SkyentificGit/SmallRobotArm/README.md

# SmallRobotArm
This is the open source project of the 6DoF robot arm based on stepper motors

All CAD and code is licensed under GPL3: https://www.gnu.org/licenses/gpl-3.0.en.html
