SkyentificGit/SmallRobotArm/Axis/Readme

The drawing of the metal axis for joint 3, 2 and 1.
