SkyentificGit/SmallRobotArm/Axis/Axis2tube.step

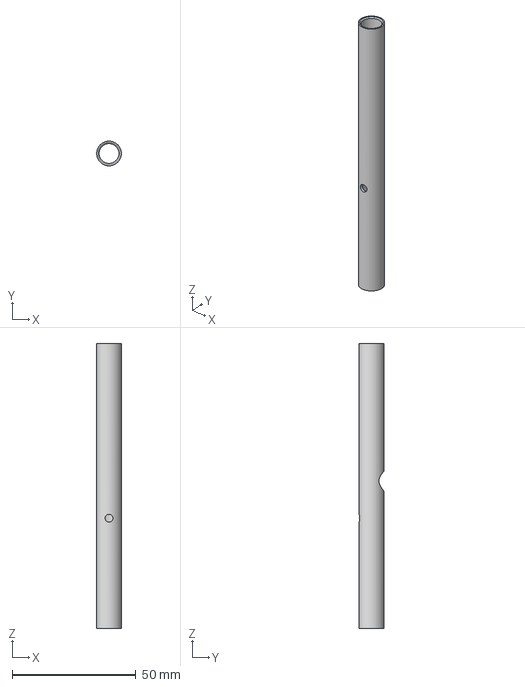
[picture p1: CAD file, 2019-01-30]
Axis/Axis2tube.step
9.99 x 10.00 x 115.0 mm
