SkyentificGit/SmallRobotArm/CarbonFibre/Axis2part1.stl

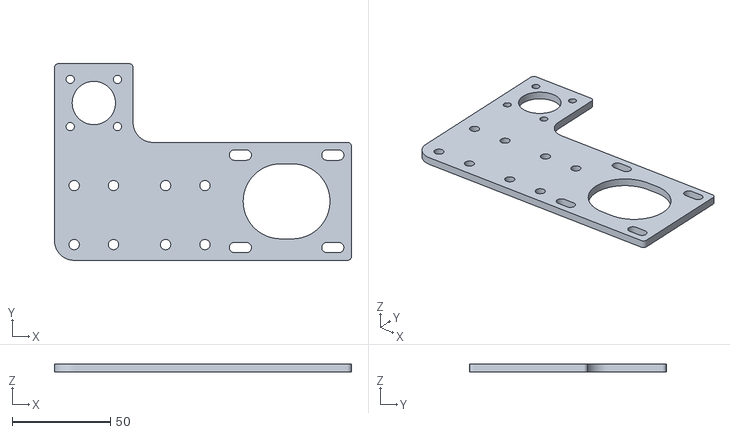
[picture p2: CAD file, 2019-01-02]
CarbonFibre/Axis2part1.stl
151.0 x 100.0 x 4.00
