SkyentificGit/SmallRobotArm/Fusion360/AxisTot1 v14.step

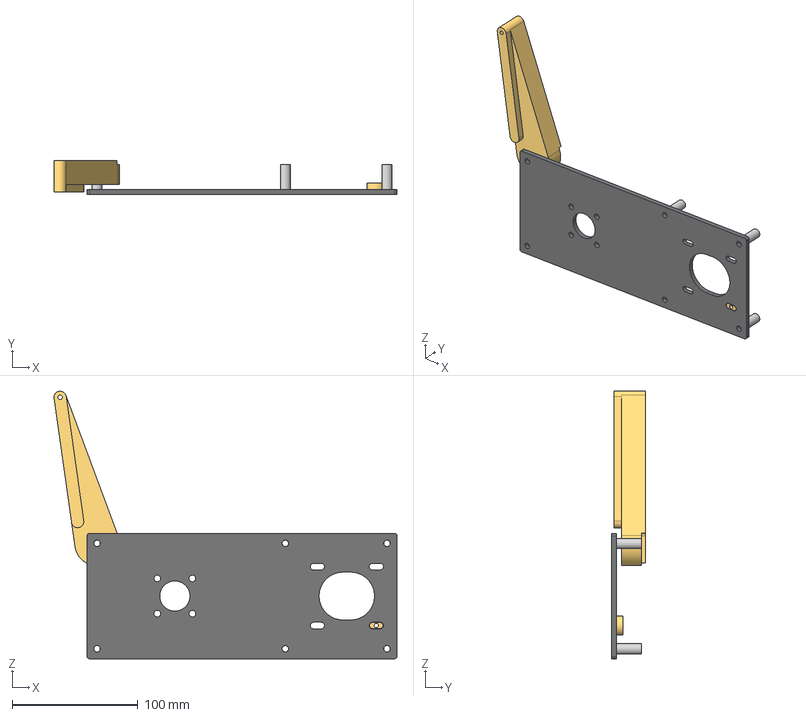
[picture p3: CAD file, 2019-09-09]
Fusion360/AxisTot1 v14.step
273.3 x 27.0 x 213.2 mm
Axis1part2_1
M5standoff_6 x 6
LegLeft
FootHolder
