SkyentificGit/SmallRobotArm/STL/Cover.stl

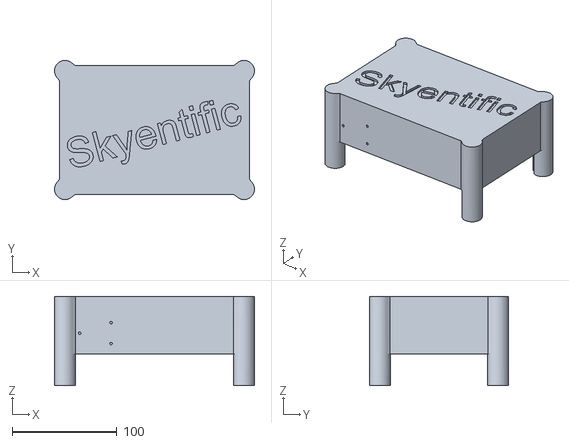
[picture p4: CAD file, 2019-02-20]
STL/Cover.stl
191.0 x 133.0 x 85.0
