SkyentificGit/SmallRobotArm/Axis/Axis3tube.step

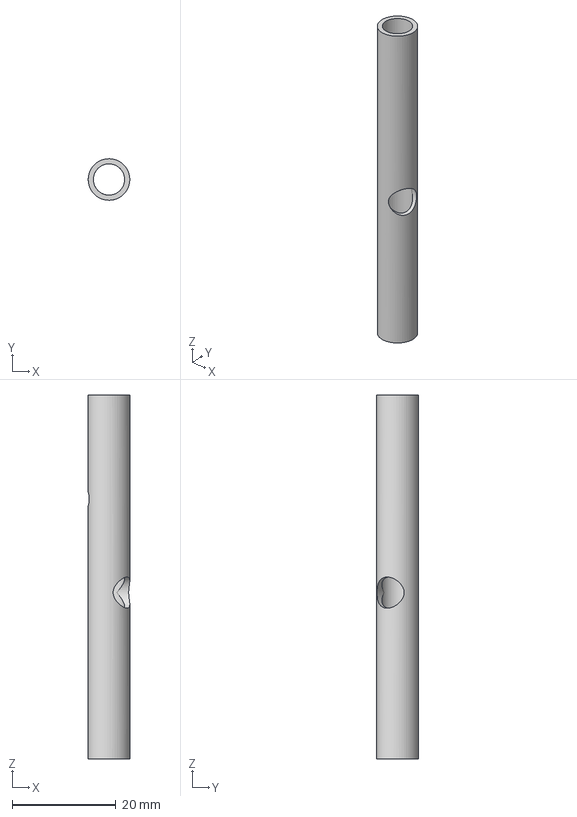
[picture p5: CAD file, 2019-01-30]
Axis/Axis3tube.step
8.00 x 8.00 x 70.0 mm
