SkyentificGit/SmallRobotArm/CarbonFibre/Axis1part2.stl

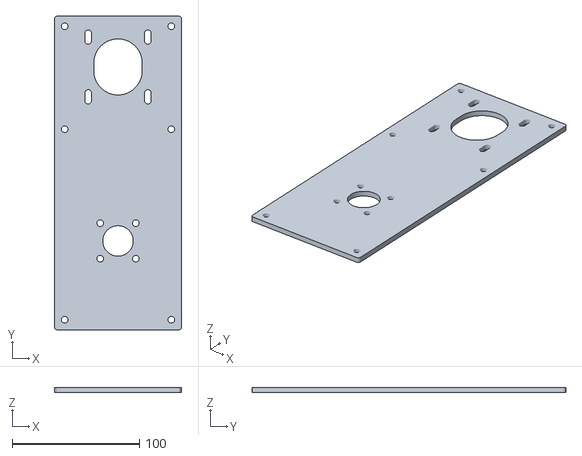
[picture p6: CAD file, 2019-01-02]
CarbonFibre/Axis1part2.stl
100.0 x 247.0 x 4.00
