SkyentificGit/SmallRobotArm/Fusion360/axis6motorHolder v47.step

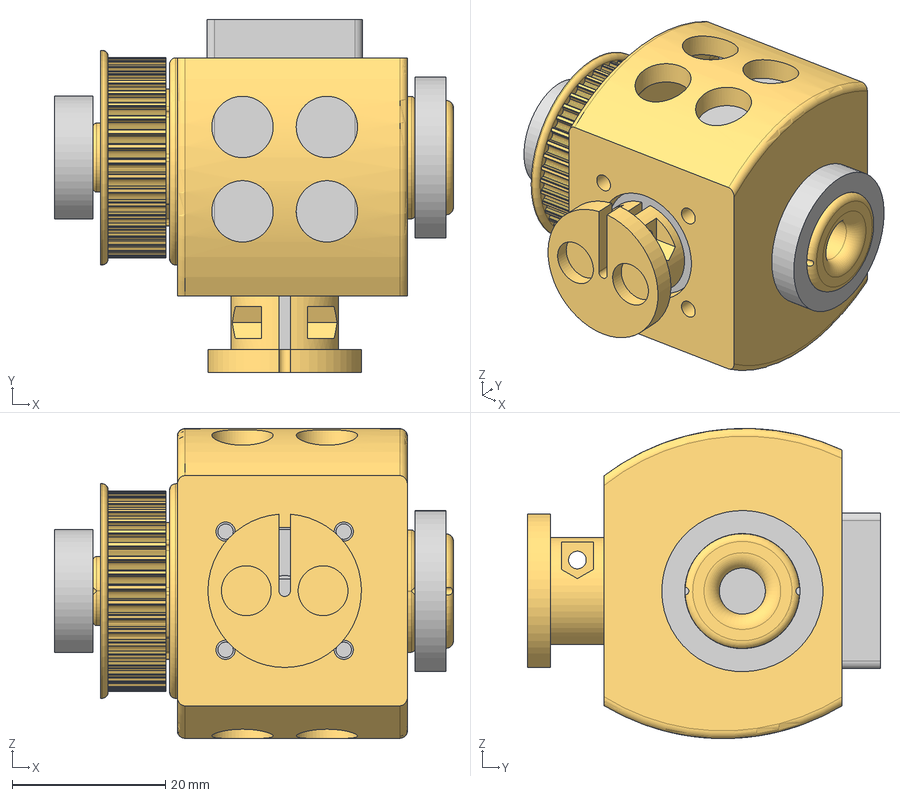
[picture p7: CAD file, 2019-09-09]
Fusion360/axis6motorHolder v47.step
52.0 x 46.0 x 40.4 mm
axis6motorHolder_1
Pulley42
Bearing16_8_5_1
Bearing21_15_4_1
Nema8_1
Axis6_1
