SkyentificGit/SmallRobotArm/STL/Electronics.stl

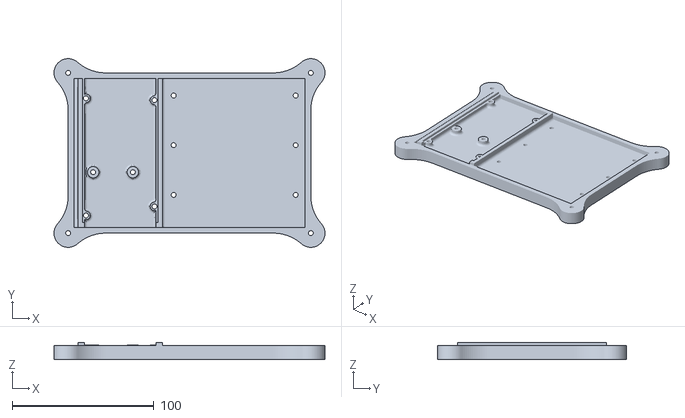
[picture p8: CAD file, 2019-01-26]
STL/Electronics.stl
191.0 x 133.0 x 12.2
