SkyentificGit/SmallRobotArm/Axis/Axis1tube.step

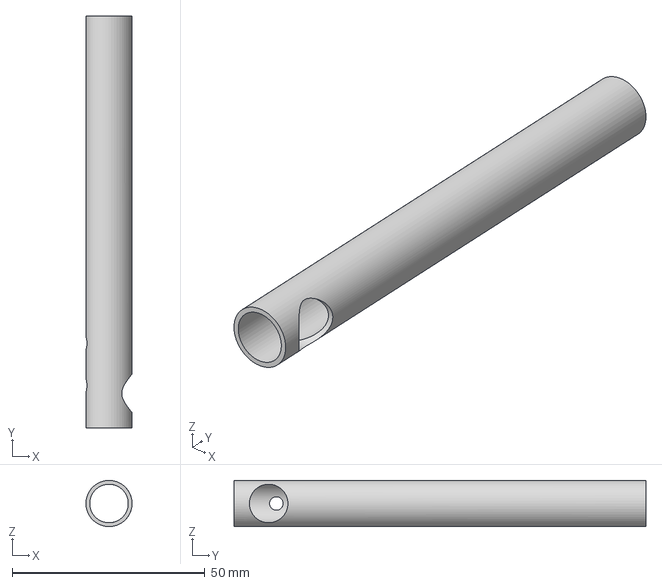
[picture p9: CAD file, 2019-01-30]
Axis/Axis1tube.step
12.0 x 107.0 x 12.0 mm
