SkyentificGit/SmallRobotArm/CarbonFibre/Axis3part1.stl

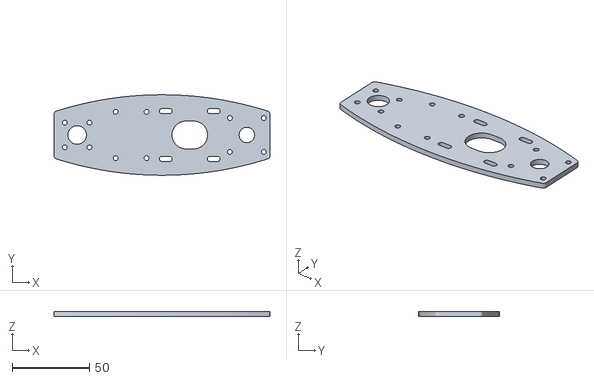
[picture p10: CAD file, 2019-01-02]
CarbonFibre/Axis3part1.stl
140.0 x 52.2 x 3.00
