SkyentificGit/SmallRobotArm/Fusion360/Axis6 v13.step

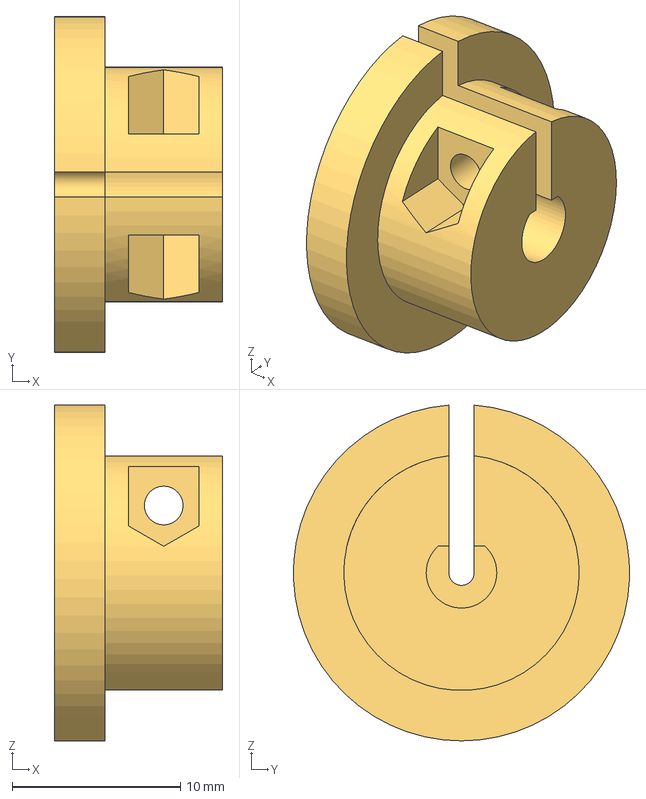
[picture p11: CAD file, 2019-09-09]
Fusion360/Axis6 v13.step
10.0 x 20.0 x 20.0 mm
