SkyentificGit/SmallRobotArm/STL/LegLeft.stl

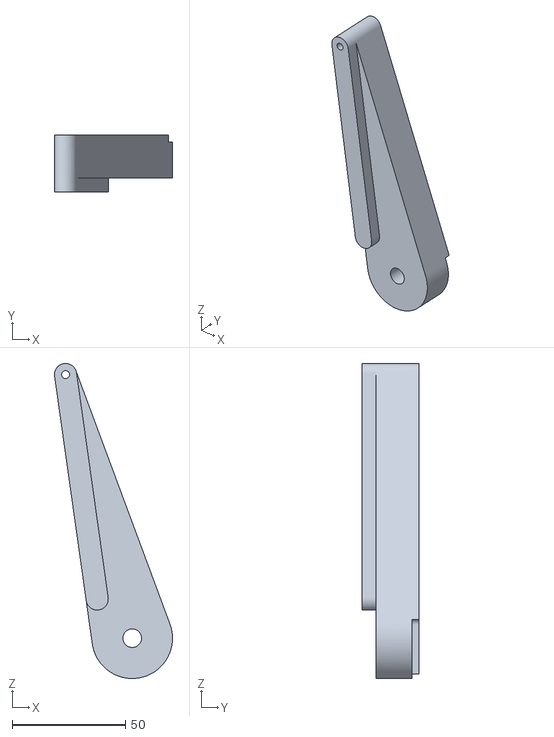
[picture p12: CAD file, 2019-01-14]
STL/LegLeft.stl
52.1 x 25.0 x 139.0
