SkyentificGit/SmallRobotArm/STL/Axis2bearingHC.stl

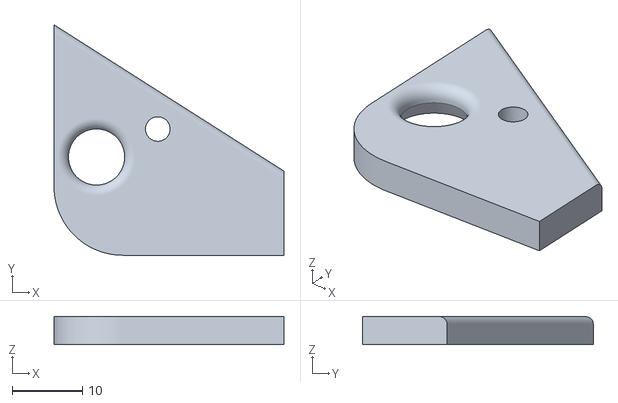
[picture p13: CAD file, 2019-01-02]
STL/Axis2bearingHC.stl
32.8 x 32.9 x 4.00
