SkyentificGit/SmallRobotArm/STL/Axis2part2.stl

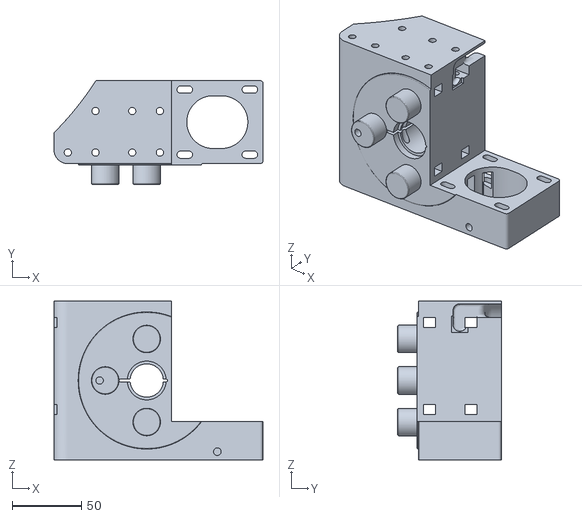
[picture p14: CAD file, 2019-01-02]
STL/Axis2part2.stl
151.0 x 75.0 x 114.8
