SkyentificGit/SmallRobotArm/STL/FootHolder.stl

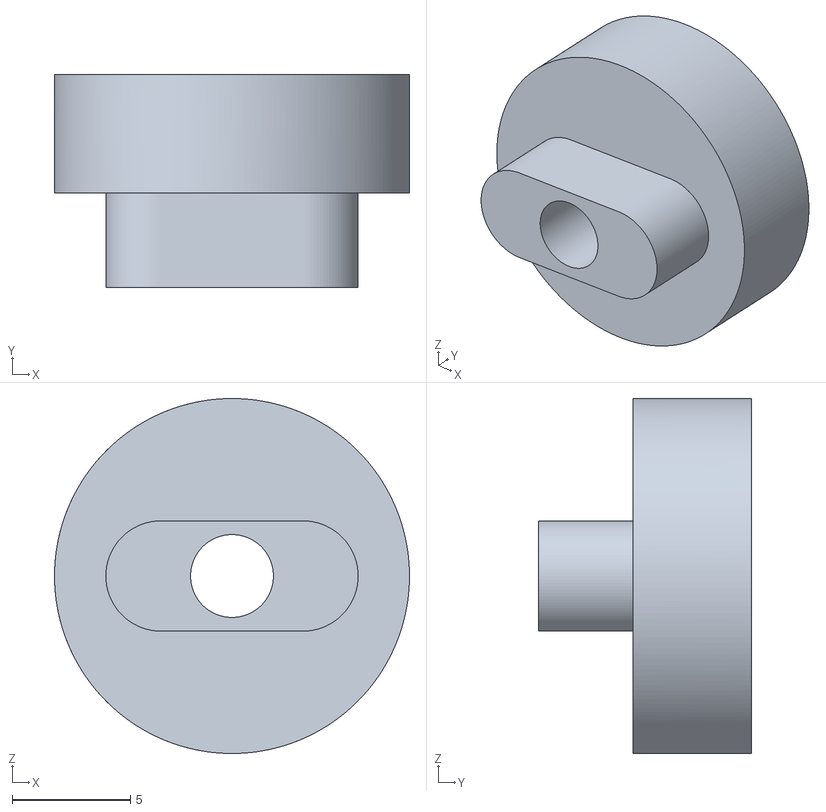
[picture p15: CAD file, 2019-01-02]
STL/FootHolder.stl
15.0 x 9.00 x 15.0
