SkyentificGit/SmallRobotArm/STL/Axis2MotorOpC.stl

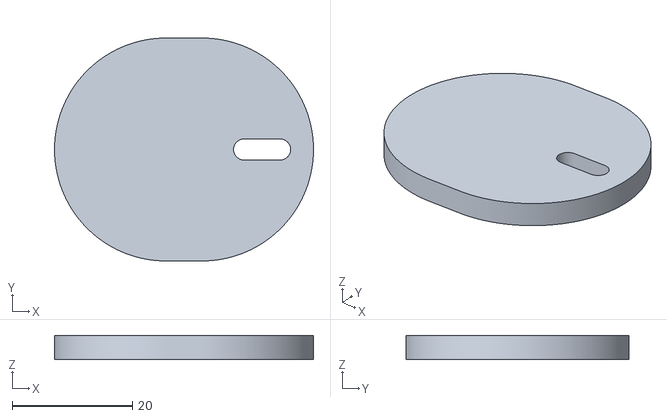
[picture p16: CAD file, 2019-01-02]
STL/Axis2MotorOpC.stl
43.1 x 37.1 x 4.00
