SkyentificGit/SmallRobotArm/STL/Axis2MotorOp.stl

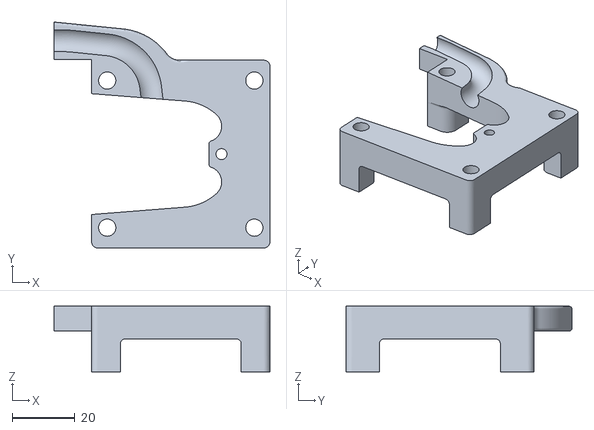
[picture p17: CAD file, 2019-01-02]
STL/Axis2MotorOp.stl
69.0 x 72.2 x 21.0
