SkyentificGit/SmallRobotArm/STL/Axis1MotorHolderOp.stl

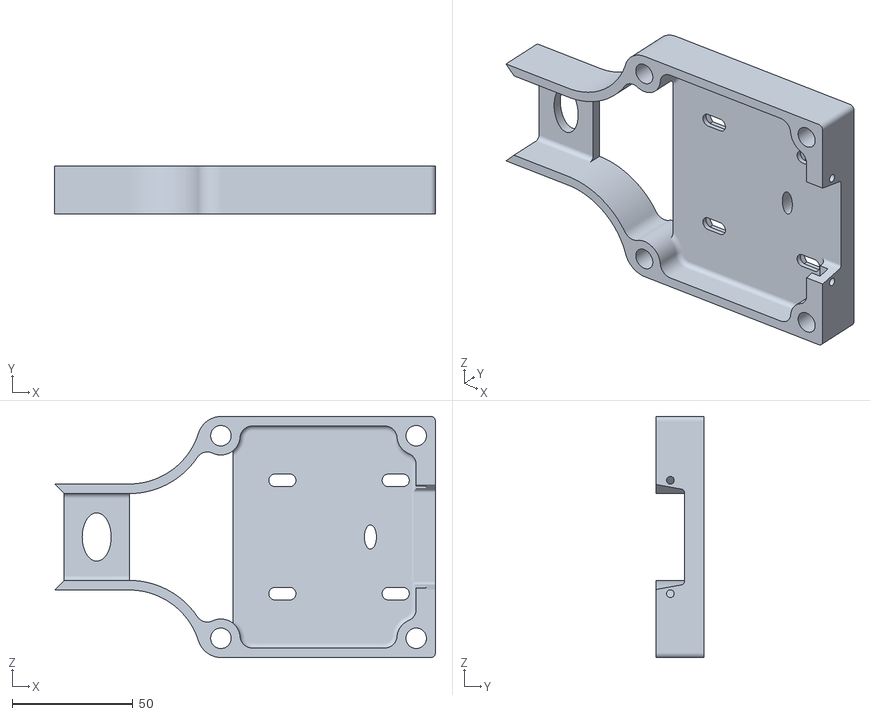
[picture p18: CAD file, 2019-01-02]
STL/Axis1MotorHolderOp.stl
158.0 x 20.0 x 100.0
