SkyentificGit/SmallRobotArm/STL/Axis1Pulley.stl

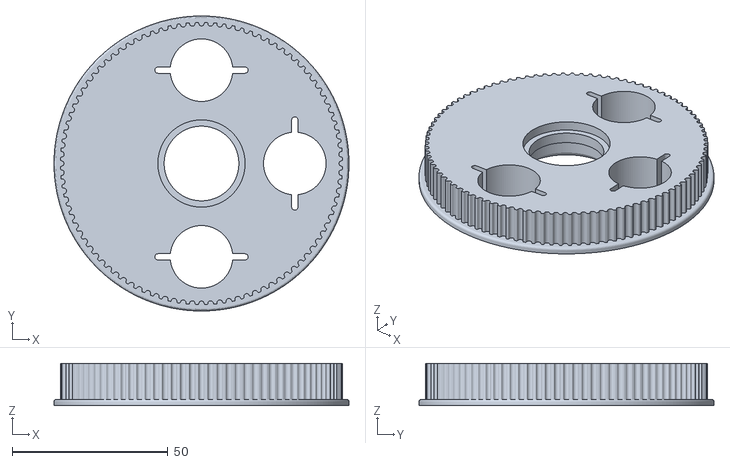
[picture p19: CAD file, 2019-01-02]
STL/Axis1Pulley.stl
94.8 x 94.8 x 13.5
