SkyentificGit/SmallRobotArm/STL/Axis2bearingHolder.stl

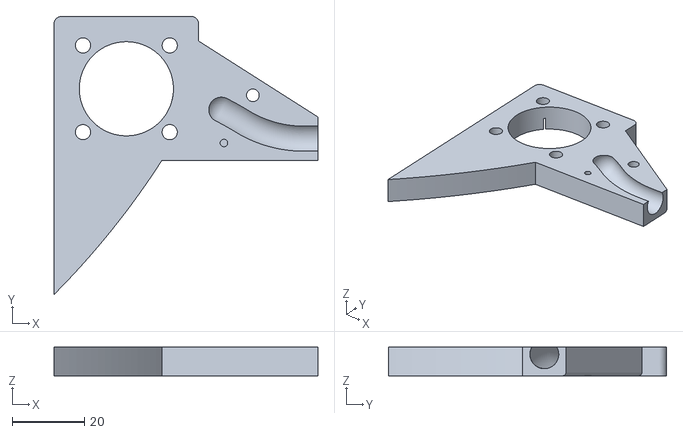
[picture p20: CAD file, 2019-01-02]
STL/Axis2bearingHolder.stl
73.0 x 76.9 x 8.00
