SkyentificGit/SmallRobotArm/STL/Axis1MotorHolder.stl

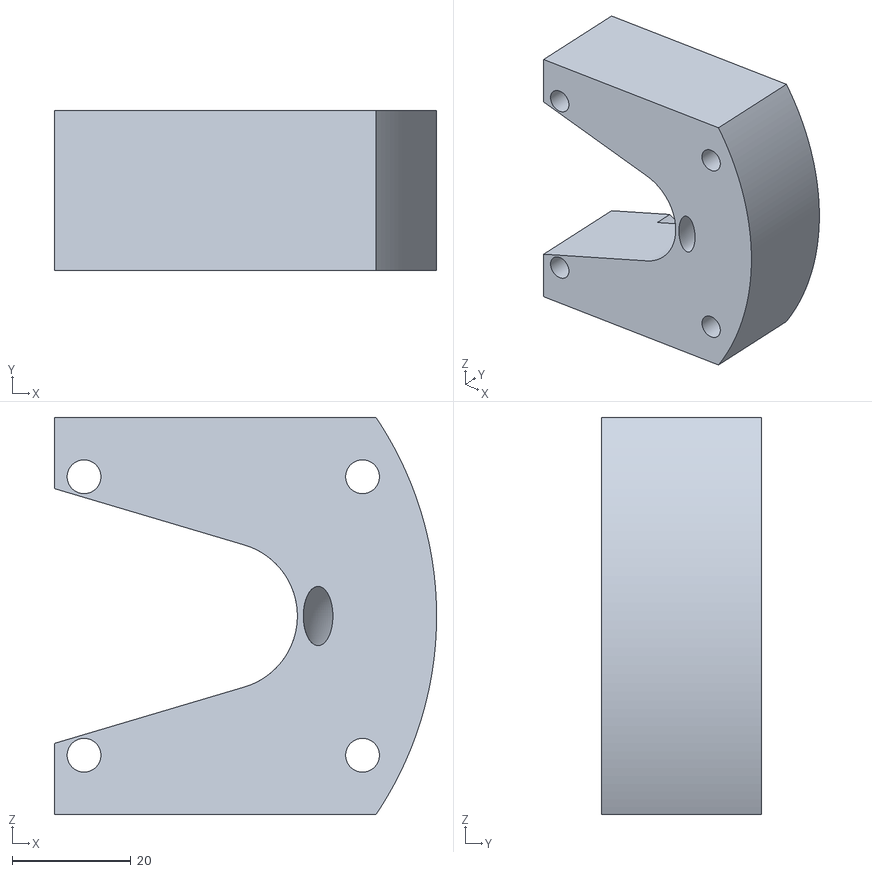
[picture p21: CAD file, 2019-01-02]
STL/Axis1MotorHolder.stl
64.5 x 27.0 x 67.0
