SkyentificGit/SmallRobotArm/STL/Axis1Holder.stl

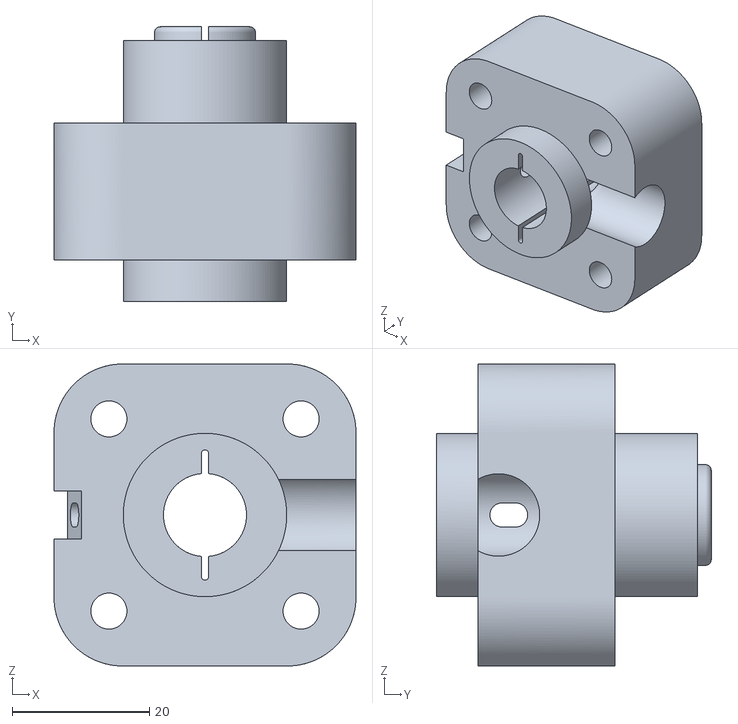
[picture p22: CAD file, 2019-01-02]
STL/Axis1Holder.stl
44.0 x 40.0 x 44.0
