SkyentificGit/SmallRobotArm/STL/axis6motorHolder.stl

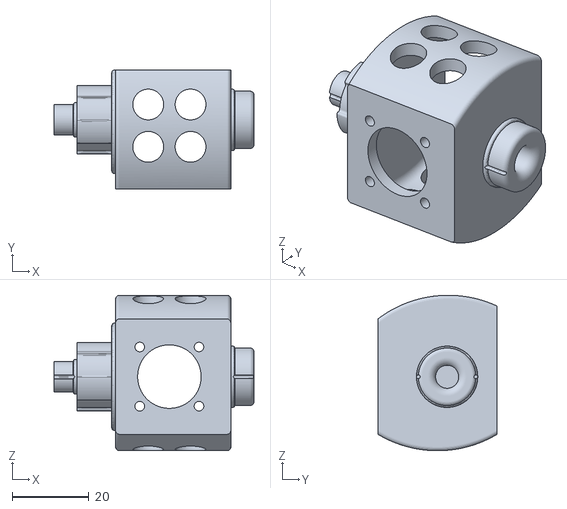
[picture p23: CAD file, 2018-12-24]
STL/axis6motorHolder.stl
52.0 x 31.0 x 40.4
