SkyentificGit/SmallRobotArm/STL/Axis3bearingHolder.stl

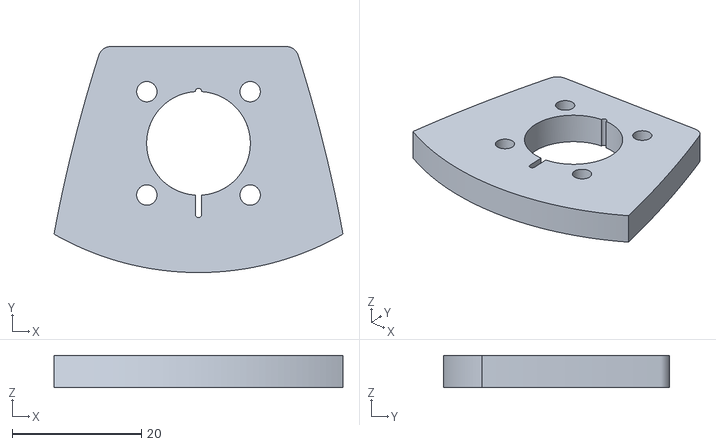
[picture p24: CAD file, 2018-12-24]
STL/Axis3bearingHolder.stl
44.7 x 35.0 x 5.00
