SkyentificGit/SmallRobotArm/STL/Axis4.stl

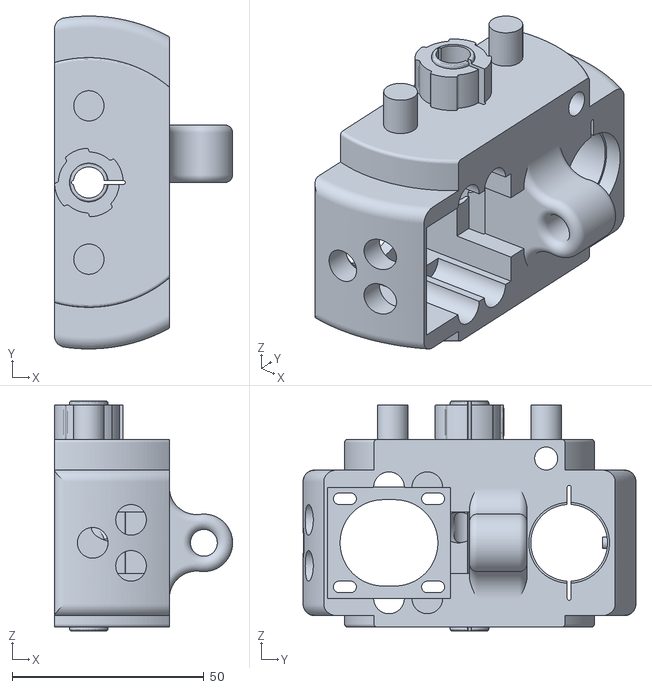
[picture p25: CAD file, 2018-12-24]
STL/Axis4.stl
46.5 x 86.8 x 60.0
