SkyentificGit/SmallRobotArm/STL/Axis6.stl

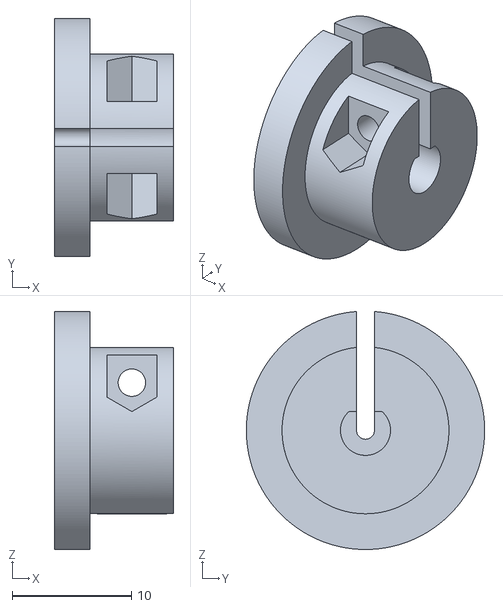
[picture p26: CAD file, 2018-12-24]
STL/Axis6.stl
10.0 x 20.0 x 20.0
