SkyentificGit/SmallRobotArm/STL/Axis5.stl

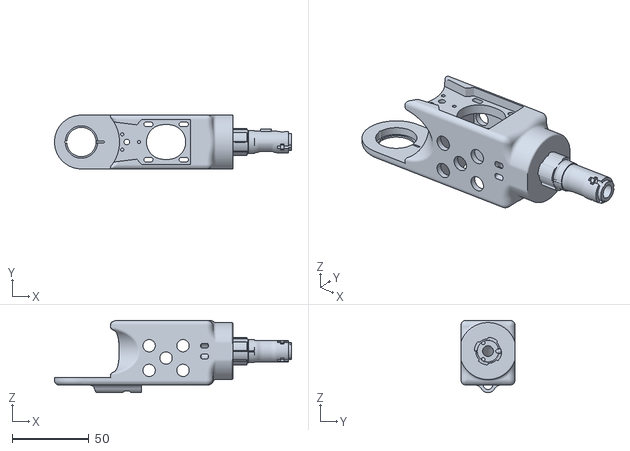
[picture p27: CAD file, 2018-12-24]
STL/Axis5.stl
154.0 x 35.0 x 47.0
