SkyentificGit/SmallRobotArm/STL/Axis4limit.stl

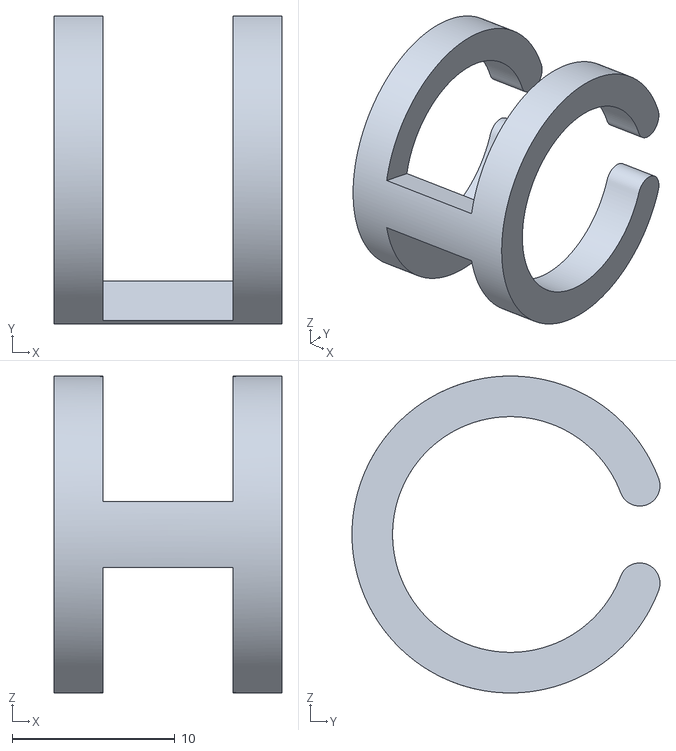
[picture p28: CAD file, 2018-12-24]
STL/Axis4limit.stl
14.0 x 19.0 x 19.5
