SkyentificGit/SmallRobotArm/STL/Axis3cover2.stl

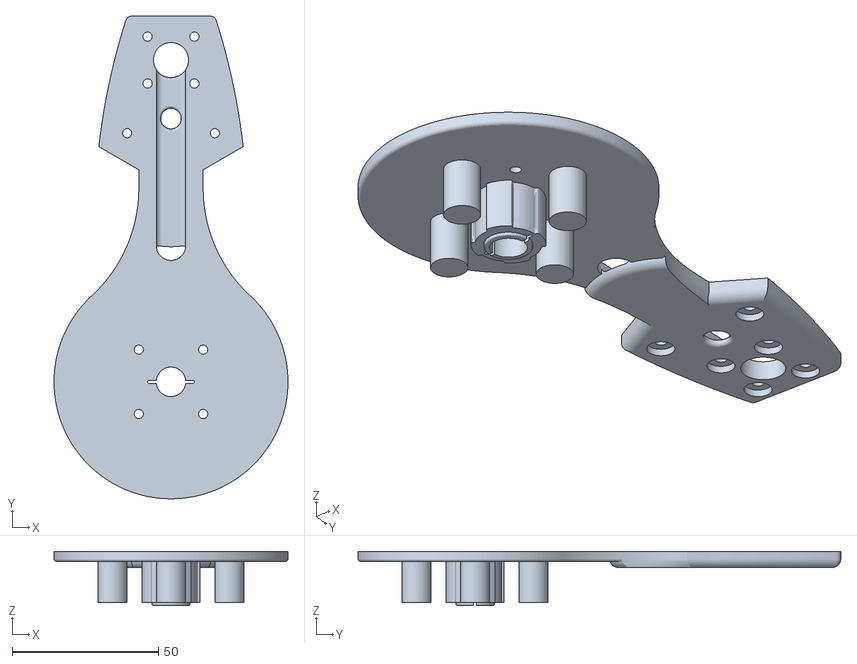
[picture p29: CAD file, 2018-12-24]
STL/Axis3cover2.stl
80.0 x 165.0 x 18.5
