SkyentificGit/SmallRobotArm/STL/Pulley100.stl

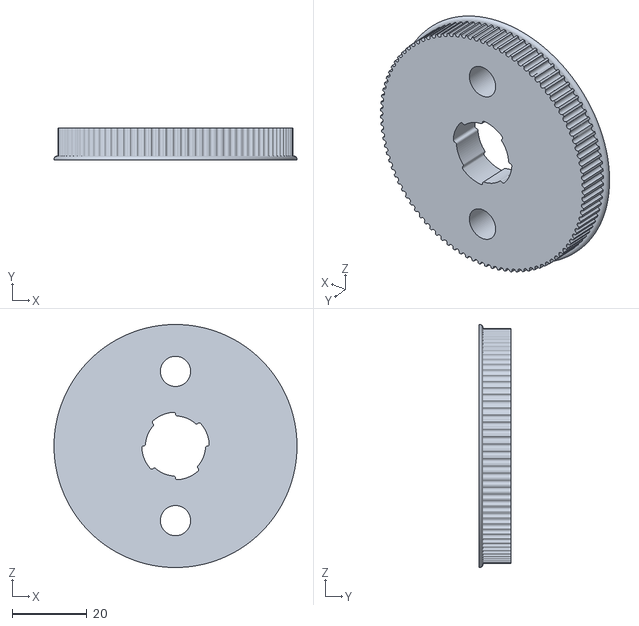
[picture p30: CAD file, 2018-12-24]
STL/Pulley100.stl
65.1 x 8.50 x 65.1
