SkyentificGit/SmallRobotArm/STL/Axis3cover1.stl

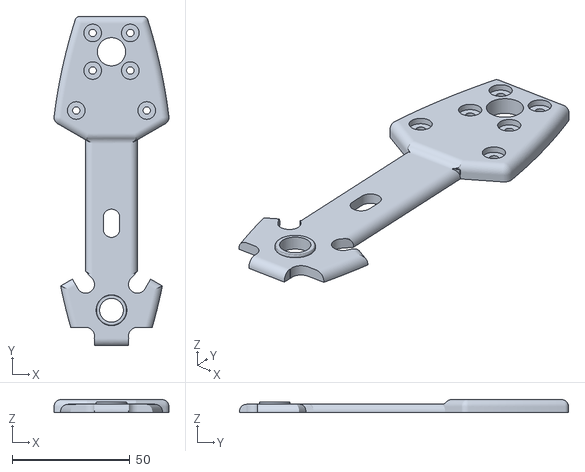
[picture p31: CAD file, 2018-12-24]
STL/Axis3cover1.stl
48.9 x 140.0 x 5.50
