SkyentificGit/SmallRobotArm/STL/Axis5Bracket.stl

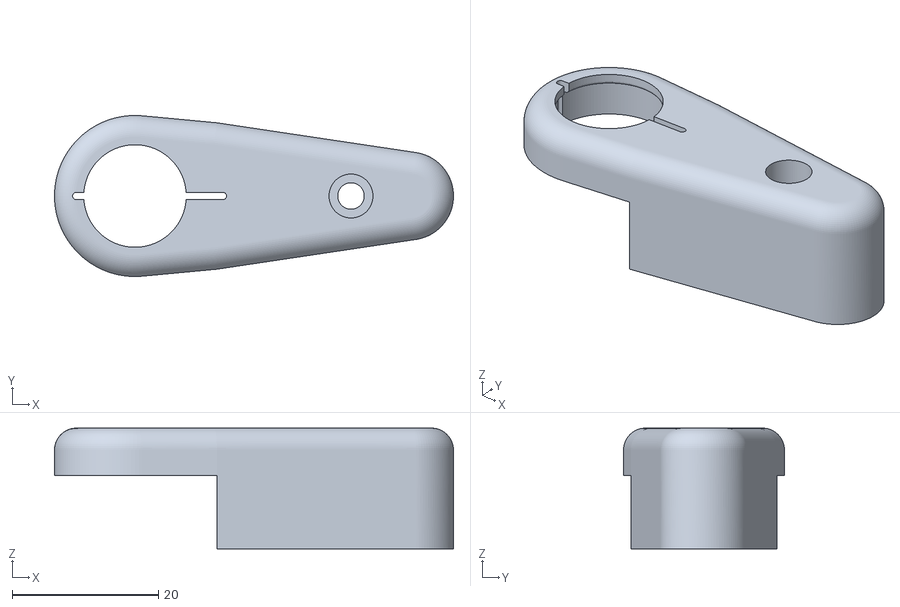
[picture p32: CAD file, 2018-12-24]
STL/Axis5Bracket.stl
54.5 x 22.0 x 16.5
