SkyentificGit/SmallRobotArm/STL/Axis2Pulley.stl

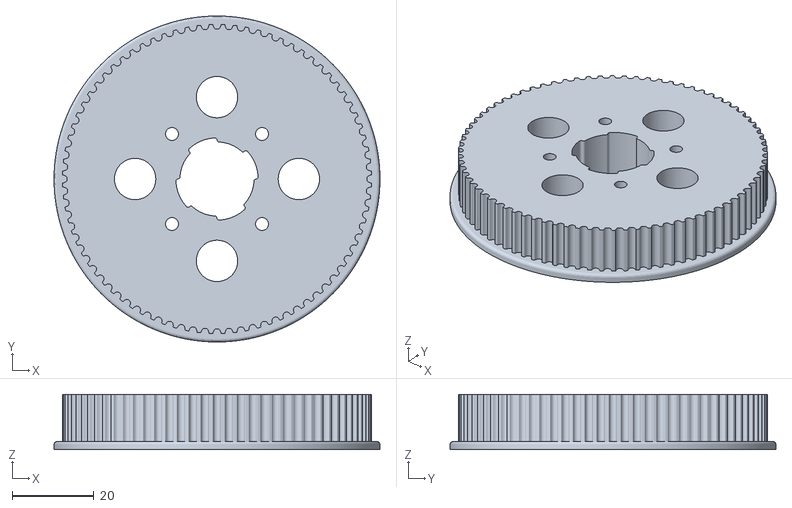
[picture p33: CAD file, 2018-12-24]
STL/Axis2Pulley.stl
79.6 x 79.6 x 13.5
