SkyentificGit/SmallRobotArm/STL/Axis5plug.stl

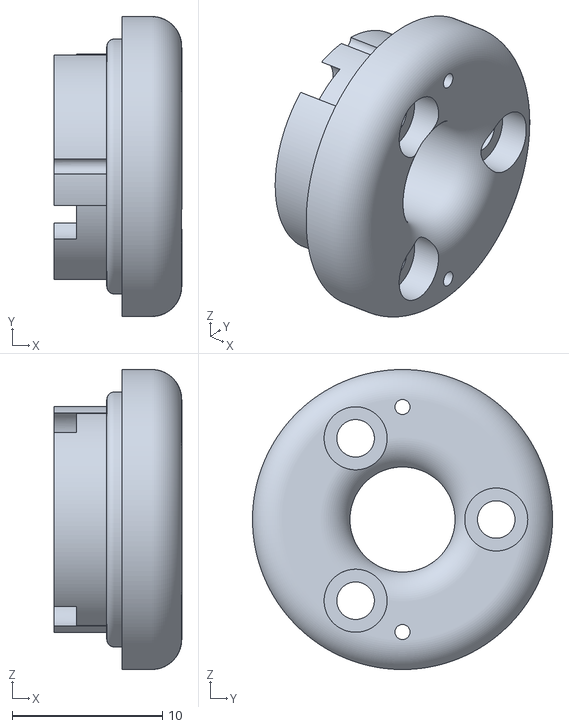
[picture p34: CAD file, 2018-12-24]
STL/Axis5plug.stl
8.50 x 20.0 x 20.0
