SkyentificGit/SmallRobotArm/STL/Pulley56.stl

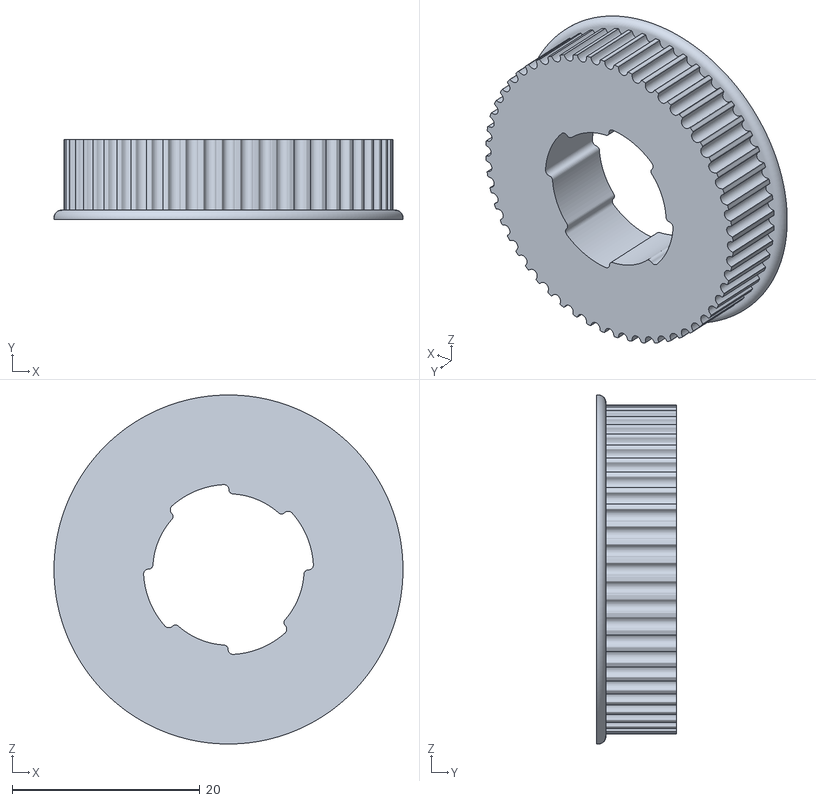
[picture p35: CAD file, 2018-12-24]
STL/Pulley56.stl
37.1 x 8.50 x 37.1
