SkyentificGit/SmallRobotArm/STL/Axis3part2.stl

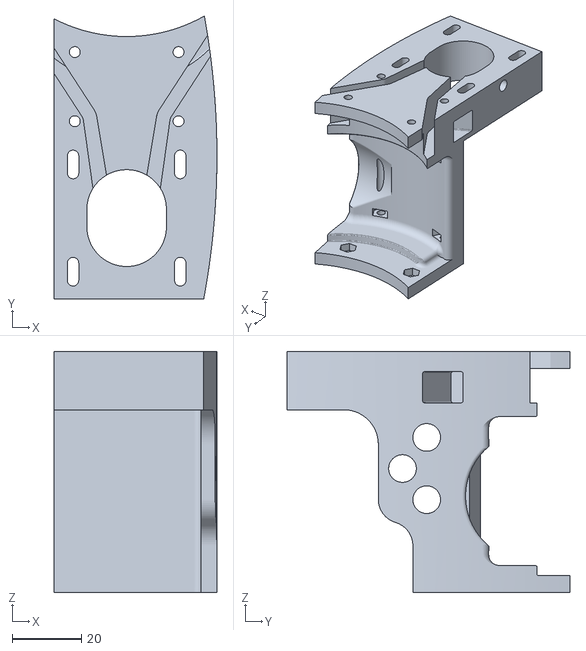
[picture p36: CAD file, 2018-12-24]
STL/Axis3part2.stl
47.1 x 81.8 x 69.8
