SkyentificGit/SmallRobotArm/STL/Axis3part3.stl

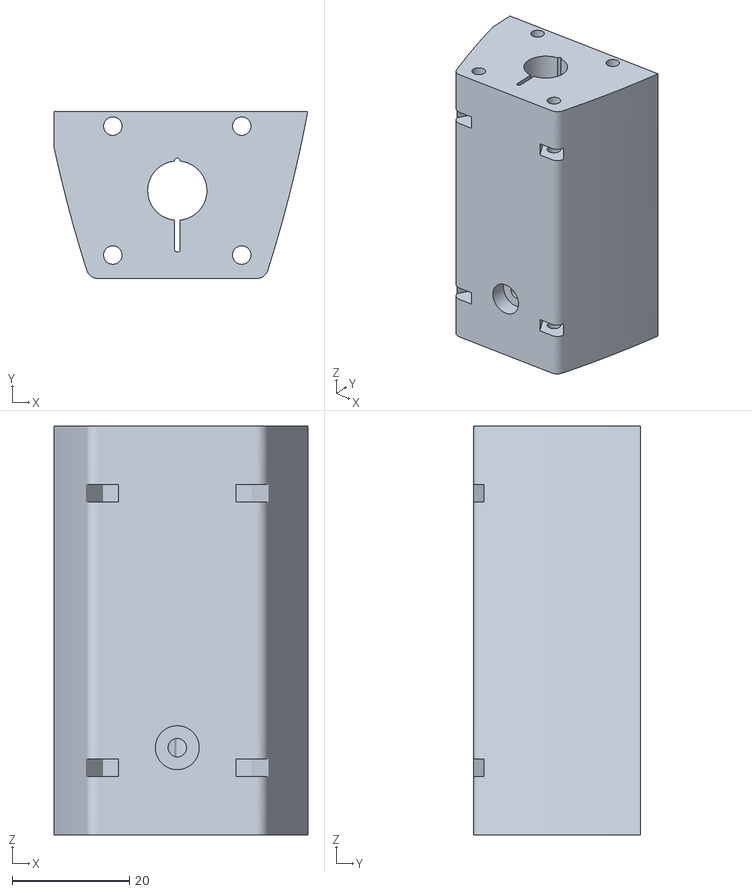
[picture p37: CAD file, 2018-12-24]
STL/Axis3part3.stl
43.3 x 28.5 x 69.8
