SkyentificGit/SmallRobotArm/STL/Pulley42.stl

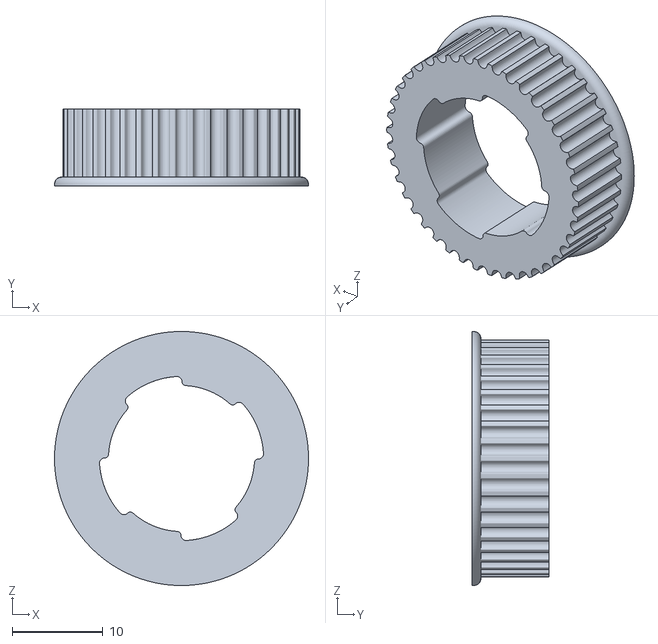
[picture p38: CAD file, 2018-12-24]
STL/Pulley42.stl
28.0 x 8.50 x 28.0
