SkyentificGit/SmallRobotArm/(list of files, cad)

Other CAD files:
Axis/Axis1tube.f3d
Axis/Axis2tube.f3d
Axis/Axis3tube.f3d
CarbonFibre/Axis1part2.DXF
CarbonFibre/Axis2part1.DXF
CarbonFibre/Axis3part1.DXF
Fusion360/AxisTot1.f3z
Fusion360/axis6motorHolder.f3z
STL/Axis1washer.stl
STL/Axis2bearingHolder (1).stl
STL/Axis2washer.stl
STL/Axis5screwHolder.stl
