SkyentificGit/SmallRobotArm/CarbonFibre/Axis1part2.PDF

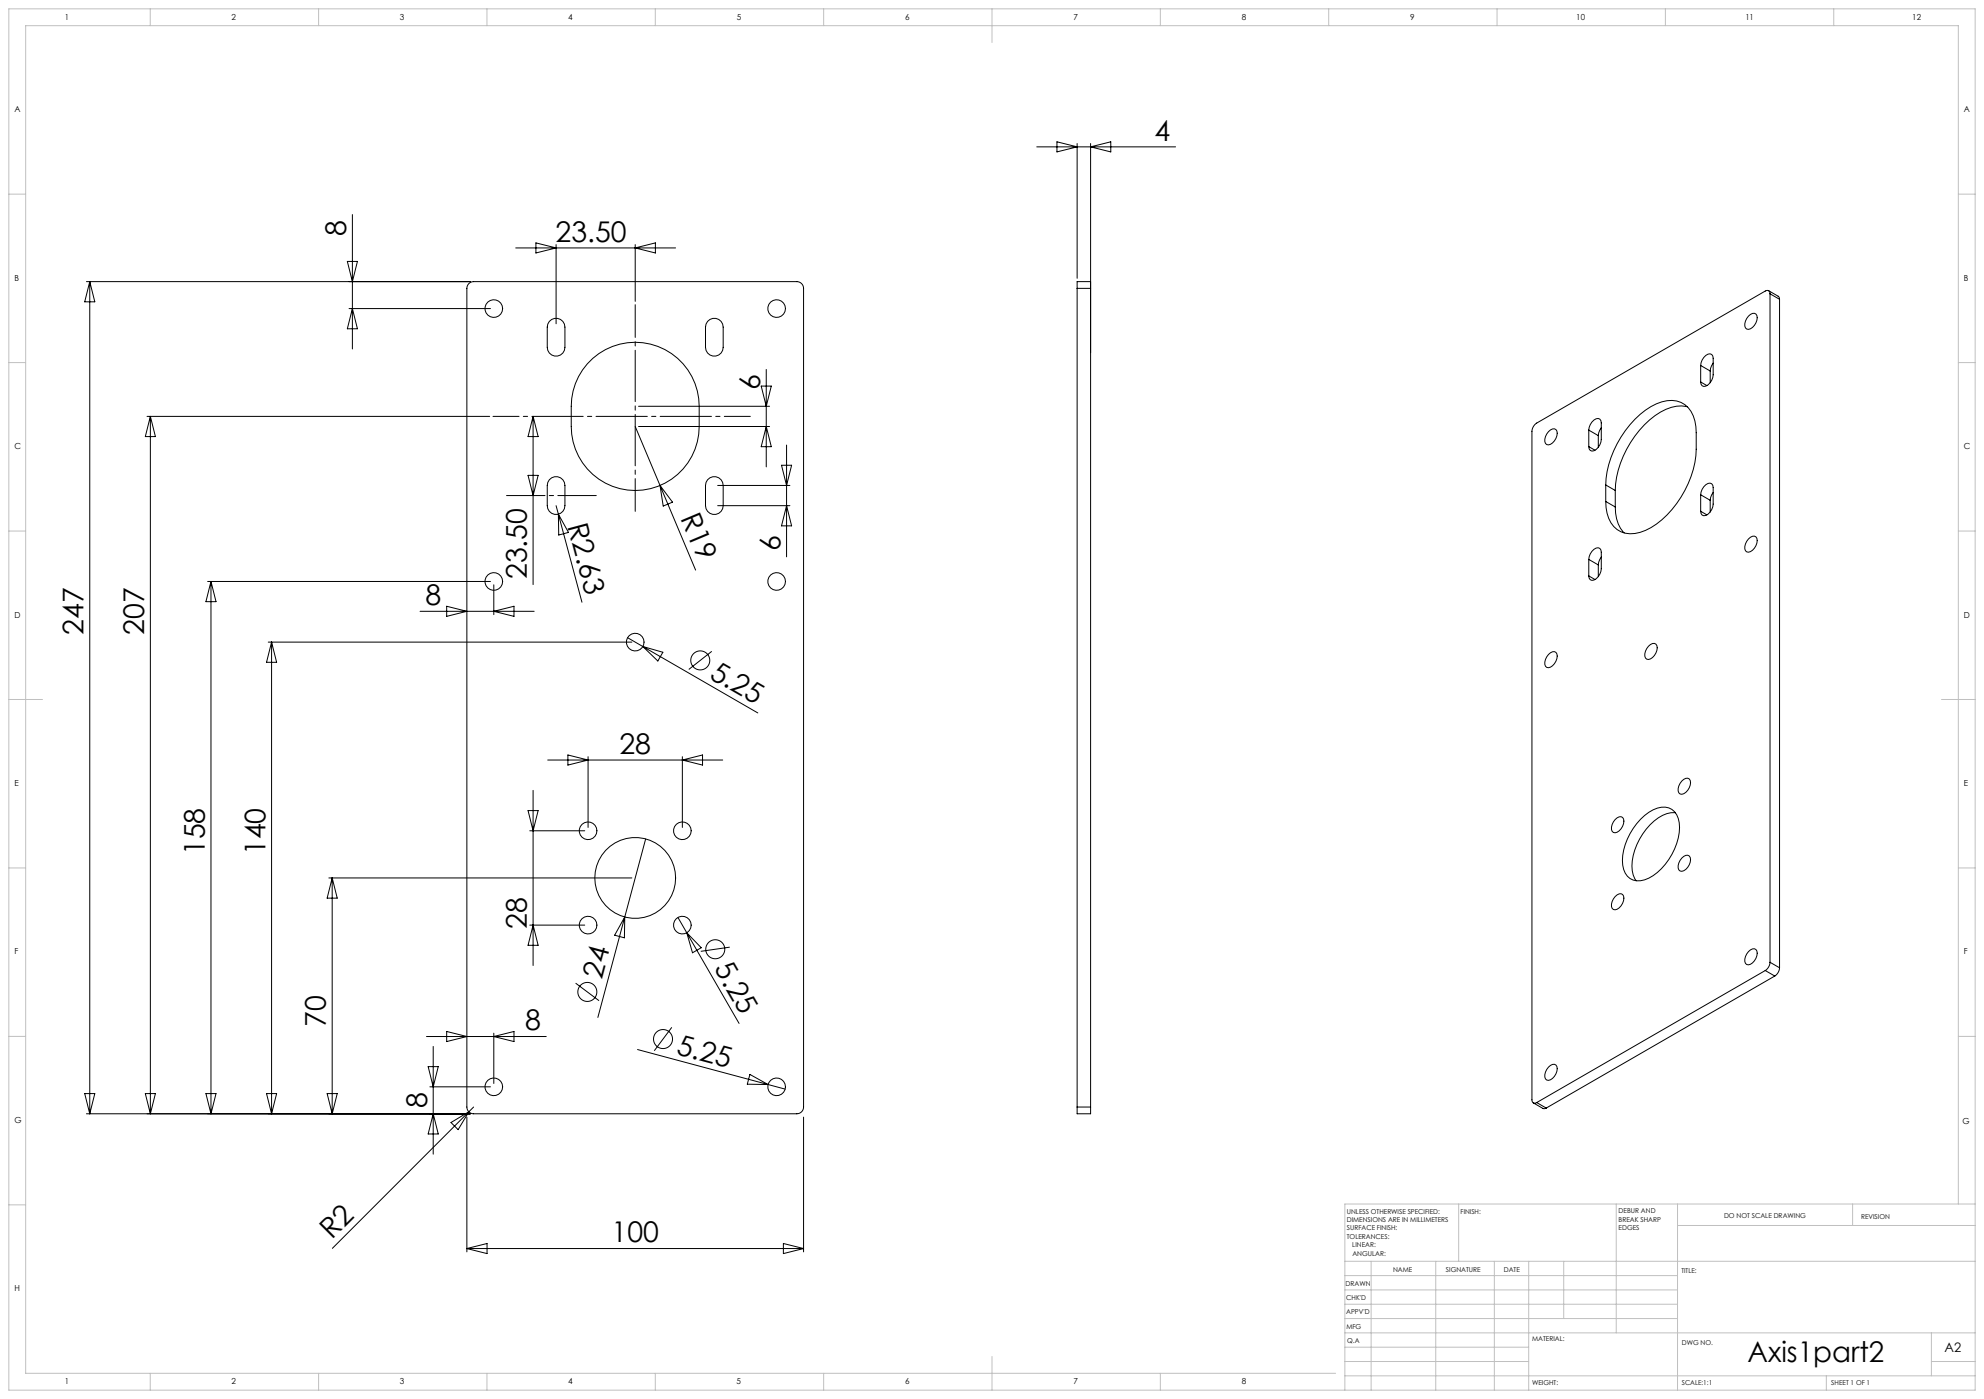
[picture p39: page 1]
SCALE:1:1; SHEET 1 OF 1

UNLESS OTHERWISE SPECIFIED: DIMENSIONS ARE IN MILLIMETERS SURFACE FINISH: TOLERANCES: LINEAR: ANGULAR: | FINISH: | DEBUR AND BREAK SHARP EDGES | DO NOT SCALE DRAWING | REVISION

NAME | SIGNATURE | DATE | | | | TITLE:
Q.A | | | | MATERIAL: | Axis1part2 WEIGHT: DWG NO. | A2

DRAWN
CHK'D
APPV'D
MFG
